SimonvanderMarel/ConfigFileESP32/Hardware design/PCBA/Design files/BOM_Home_Automation_Device_PCB1_2026-02-15.xlsx

No. | Quantity | Comment | Designator | Footprint | Value | Manufacturer Part | Manufacturer | Supplier Part | Supplier
1 | 1 | HX PH254-01-03-Z-L11.5 pcb pin header | AMS312 | HDR-TH_3P-P2.54-V-M-1 |  | HX PH254-01-03-Z-L11.5 pcb pin header | hanxia(韩下) | C52016391 | LCSC
2 | 7 | 22uF | C1,C2,C3,C4,C5,C6,C7 | C1206 | 22uF | CL31A226KAHNNNE | SAMSUNG(三星) | C12891 | LCSC
3 | 3 | 470531000 | CN1,CN2,CN3 | CONN-TH_4P-P2.54_0470531000 |  | 470531000 | MOLEX | C3025061 | LCSC
4 | 2 | SS34 | D1,D2 | SMA_L4.3-W2.6-LS5.2-RD |  | SS34 | MDD(辰达半导体) | C8678 | LCSC
5 | 1 | DC005 | DC1 | DC-IN-TH_DC005 |  | DC005 | SHOU HAN(首韩) | C431533 | LCSC
6 | 4 | DB125-2.54-3P-GN-S | DIO1,DIO2,DIO3,DIO4 | CONN-TH_DB125-2.54-3P-GN |  | DB125-2.54-3P-GN-S | DORABO(地博电气) | C918121 | LCSC
7 | 1 | FH1-200CK-B | FH1 | FUSE-TH_L24.8-W9.8-P22.60 |  | FH1-200CK-B | HONGJU(宏聚) | C268205 | LCSC
8 | 2 | BLM18PG121SN1D | L1,L2 | L0603 |  | BLM18PG121SN1D | muRata(村田) | C14709 | LCSC
9 | 3 | DB301V-3.5-2P-GN-S | P1,P2,VIN | CONN-TH_DB301V-3.5-2P-GN |  | DB301V-3.5-2P-GN-S | DORABO(地博电气) | C695629 | LCSC
10 | 2 | AO3400A | Q3,Q4 | SOT-23-3_L2.9-W1.3-P1.90-LS2.4-BR |  | AO3400A | AOS | C20917 | LCSC
11 | 4 | 330Ω | R5,R6,R11,R16 | R0603 | 330Ω | 0603WAF3300T5E | UNI-ROYAL(厚声) | C23138 | LCSC
12 | 4 | 10kΩ | R7,R8,R15,R17 | R0603 | 10kΩ | 0603WAF1002T5E | UNI-ROYAL(厚声) | C25804 | LCSC
13 | 4 | 4.7kΩ | R9,R10,R19,R20 | R0603 | 4.7kΩ | 0603WAF4701T5E | UNI-ROYAL(厚声) | C23162 | LCSC
14 | 1 | 82kΩ | R18 | R0603 | 82kΩ | 0603WAF8202T5E | UNI-ROYAL(厚声) | C23254 | LCSC
15 | 1 | ESP32-DEVKITC-VE | U1 | BULETM-SMD_ESP32-DEVKITC |  | ESP32-DEVKITC-VE | ESPRESSIF(乐鑫) | C20437001 | LCSC
16 | 1 | AMS1117-5.0 | U2 | SOT-223_L6.5-W3.5-P2.30-LS7.0-BR |  | AMS1117-5.0 | AMS | C6187 | LCSC
