SimonvanderMarel/ConfigFileESP32/Hardware design/Printed cover/Printed_Back_v2_higher.step

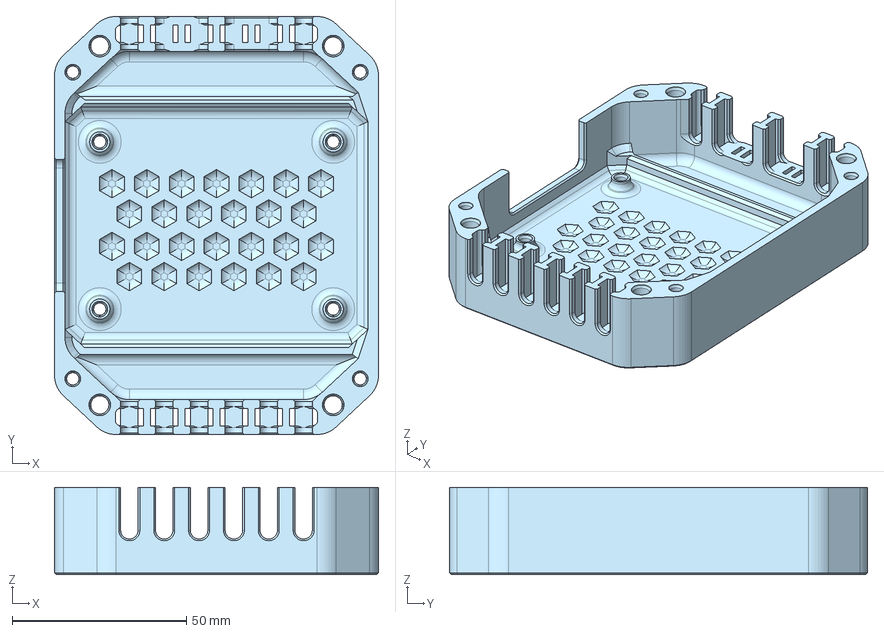
[picture p1: CAD file, 2026-04-04]
Hardware design/Printed cover/Printed_Back_v2_higher.step
93.0 x 120.0 x 25.0 mm
