SimonvanderMarel/ConfigFileESP32/Hardware design/RadiatorOptimizer/Radiator_Mount_Bracket_Type_1.step

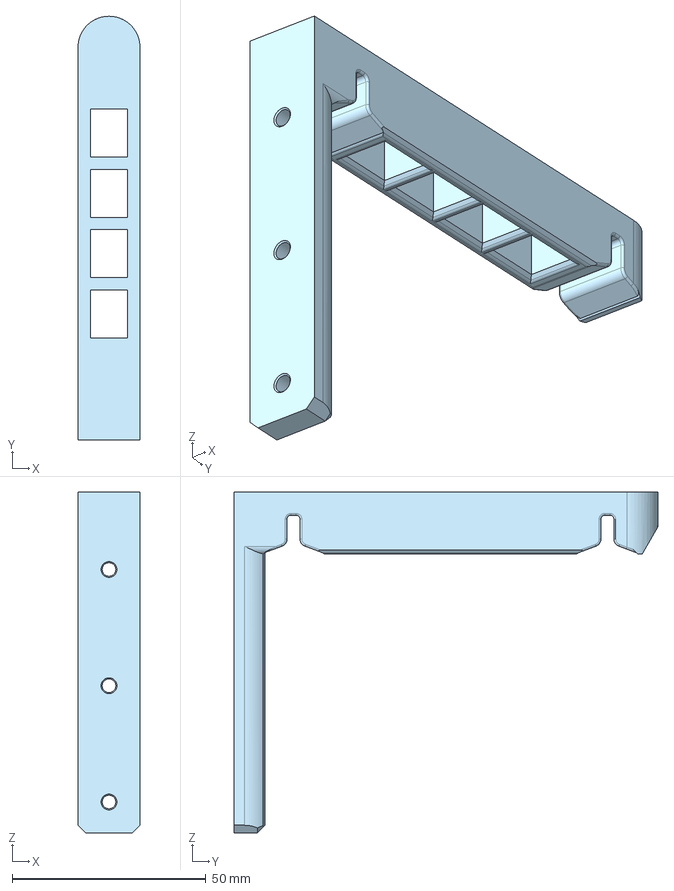
[picture p2: CAD file, 2026-04-05]
Hardware design/RadiatorOptimizer/Radiator_Mount_Bracket_Type_1.step
16.0 x 109.3 x 88.0 mm
