SimonvanderMarel/ConfigFileESP32/Hardware design/Printed cover/Printed_Cap_5mm.step

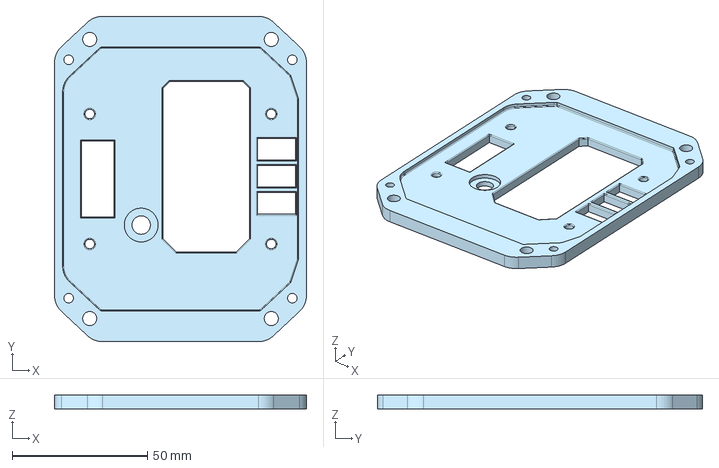
[picture p3: CAD file, 2026-04-04]
Hardware design/Printed cover/Printed_Cap_5mm.step
93.0 x 120.0 x 5.20 mm
