SimonvanderMarel/ConfigFileESP32/Hardware design/RadiatorOptimizer/Radiator_Cap_light_Sensor.step

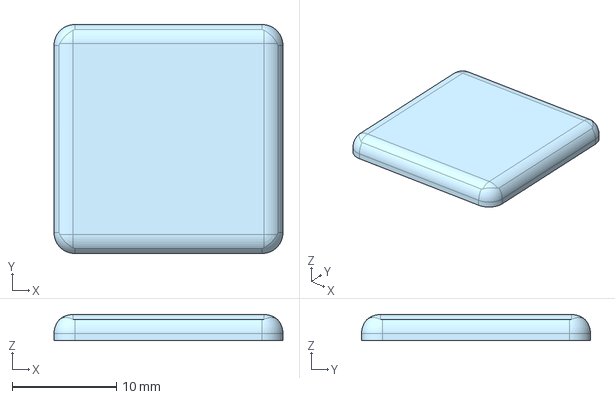
[picture p4: CAD file, 2026-04-04]
Hardware design/RadiatorOptimizer/Radiator_Cap_light_Sensor.step
22.0 x 22.0 x 2.50 mm
