SimonvanderMarel/ConfigFileESP32/Hardware design/Printed cover/Printed_Cap.step

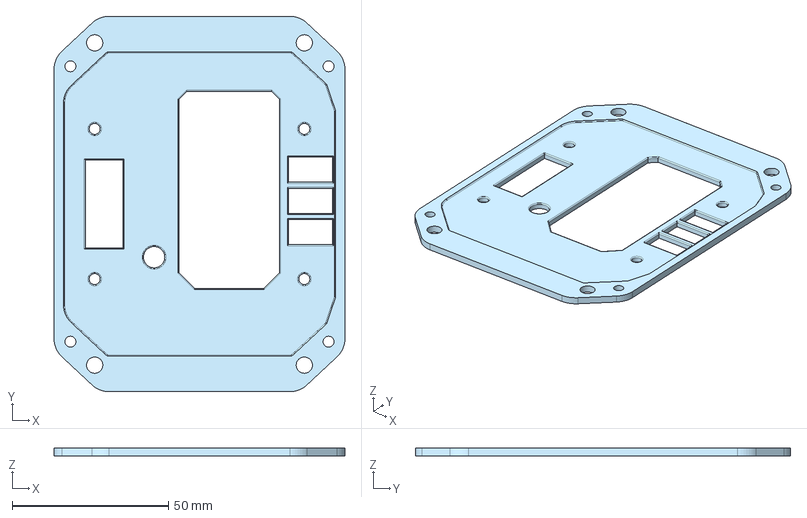
[picture p5: CAD file, 2026-03-26]
Hardware design/Printed cover/Printed_Cap.step
93.0 x 120.0 x 2.40 mm
