SimonvanderMarel/ConfigFileESP32/Hardware design/RadiatorOptimizer/Radiator_Cap_Lower.step

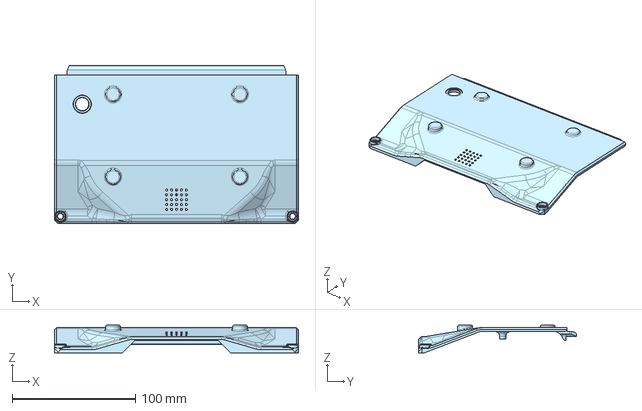
[picture p6: CAD file, 2026-04-04]
Hardware design/RadiatorOptimizer/Radiator_Cap_Lower.step
198.0 x 128.6 x 22.4 mm
