SimonvanderMarel/ConfigFileESP32/Hardware design/Printed cover/Printed_Back.step

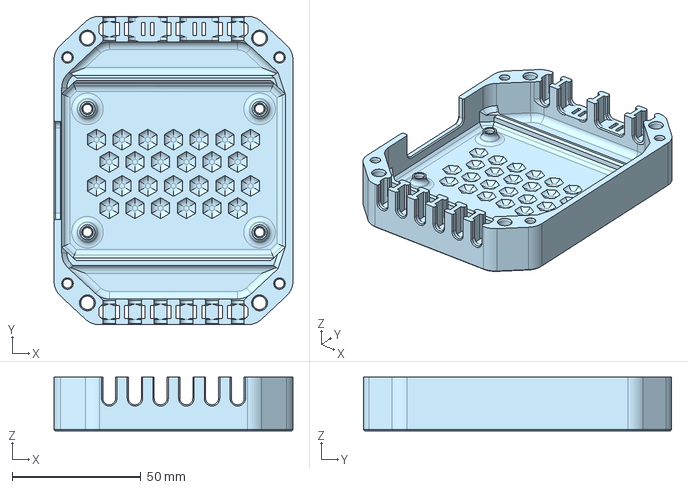
[picture p7: CAD file, 2026-03-26]
Hardware design/Printed cover/Printed_Back.step
93.0 x 120.0 x 21.0 mm
