SimonvanderMarel/ConfigFileESP32/Hardware design/RadiatorOptimizer/Radiator_PCB_Holder.step

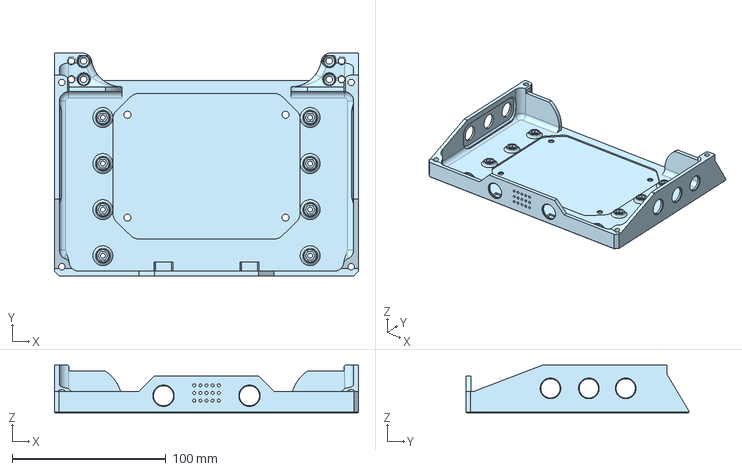
[picture p8: CAD file, 2026-04-04]
Hardware design/RadiatorOptimizer/Radiator_PCB_Holder.step
198.0 x 145.2 x 31.2 mm
