SimonvanderMarel/ConfigFileESP32/Hardware design/RadiatorOptimizer/Radiator_FanHolders.step

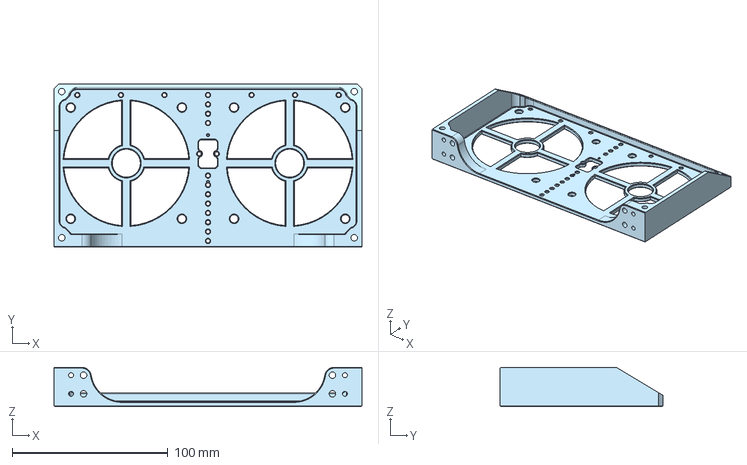
[picture p9: CAD file, 2026-04-04]
Hardware design/RadiatorOptimizer/Radiator_FanHolders.step
198.0 x 105.0 x 25.2 mm
