SimonvanderMarel/ConfigFileESP32/Hardware design/RadiatorOptimizer/Radiator_Cap_Higher.step

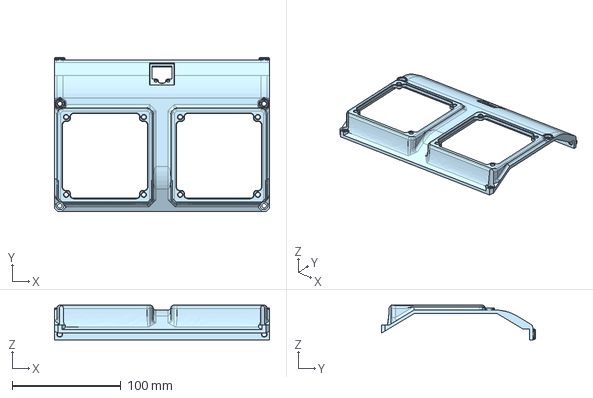
[picture p10: CAD file, 2026-04-04]
Hardware design/RadiatorOptimizer/Radiator_Cap_Higher.step
198.0 x 141.4 x 32.2 mm
