SimonvanderMarel/ConfigFileESP32/(list of files, cad)

Other CAD files:
Hardware design/Printed cover/Printed_Back.stl
Hardware design/Printed cover/Printed_Cap.stl
