SimonvanderMarel/ConfigFileESP32/Hardware design/PCBA/SCH_Home_Automation_Device_2026-02-15.pdf

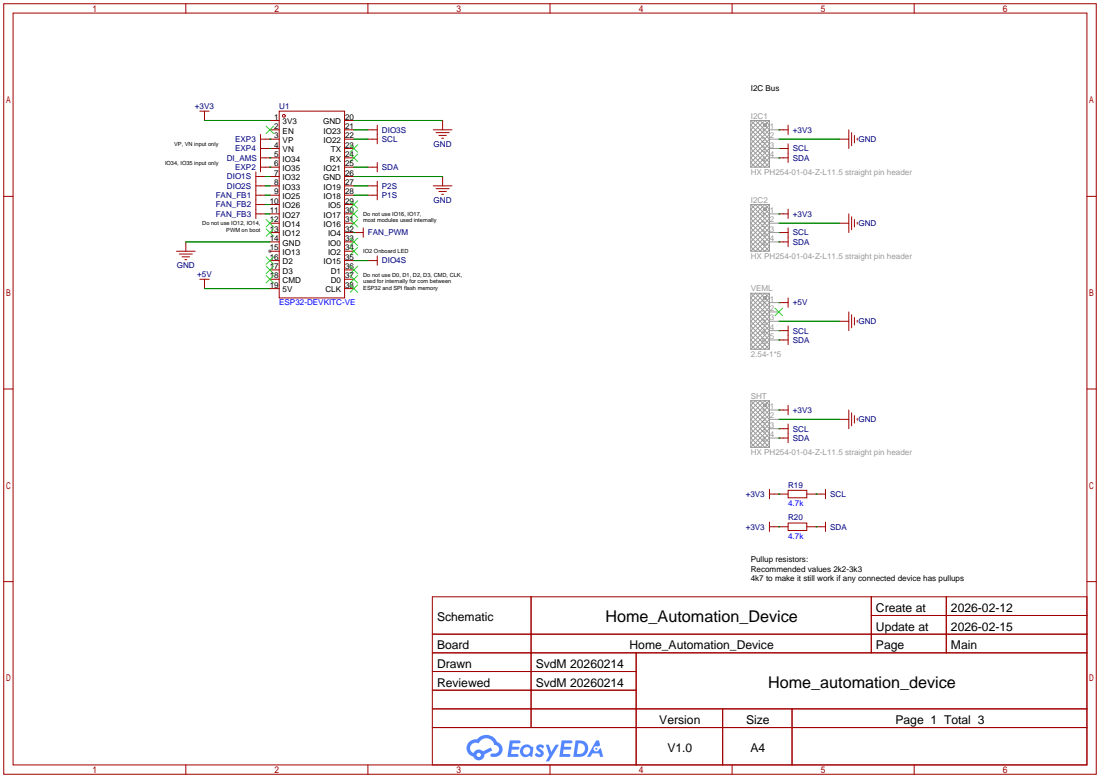
[picture p11: page 1]

VP, VN input only

Do not use IO16, IO17,
most modules used internally
FAN_PWM

Do not use D0, D1, D2, D3, CMD, CLK,
used for internally for com between
ESP32 and SPI flash memory

Pullup resistors:
Recommended values 2k2-3k3
4k7 to make it still work if any connected device has pullups

Schematic | Home_Automation_Device | Create at | 2026-02-12

Update at | 2026-02-15

Board | Home_Automation_Device | Page | Main
Drawn | SvdM 20260214 | Home_automation_device
Reviewed | SvdM 20260214

Version | Size | Page 1 Total 3
V1.0 | A4

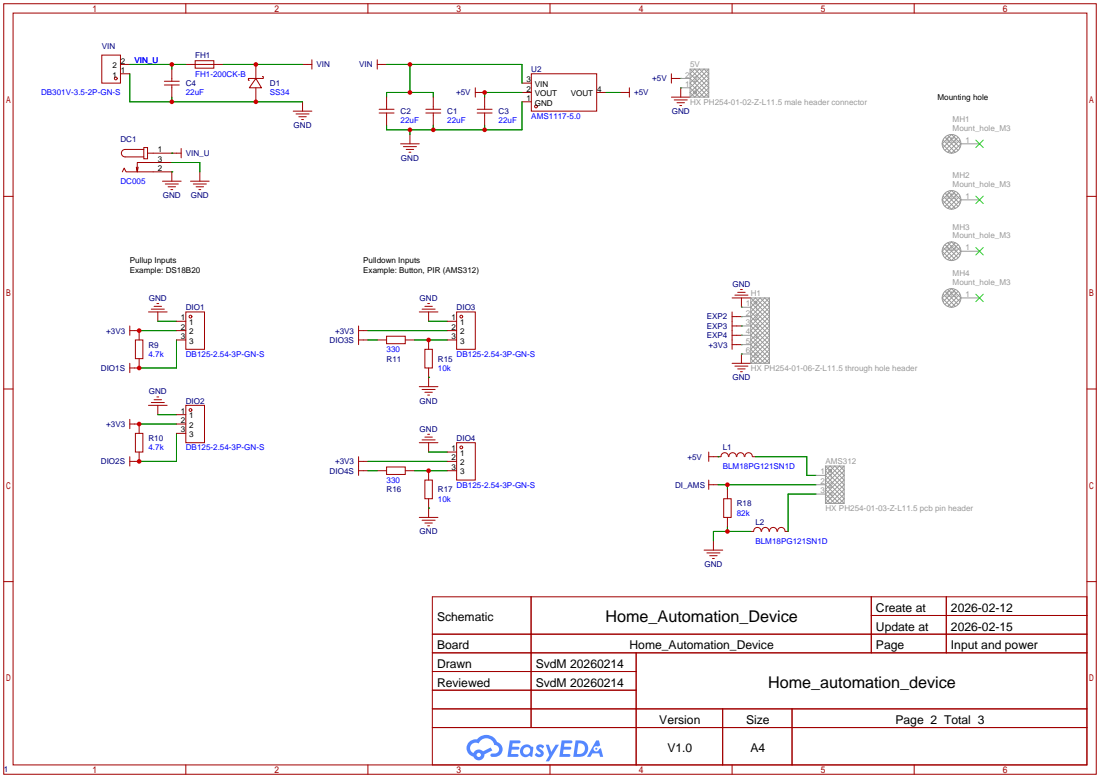
[picture p12: page 2]

Schematic | Home_Automation_Device | Create at | 2026-02-12

Update at | 2026-02-15

Board | Home_Automation_Device | Page | Input and power
Drawn | SvdM 20260214 | Home_automation_device
Reviewed | SvdM 20260214

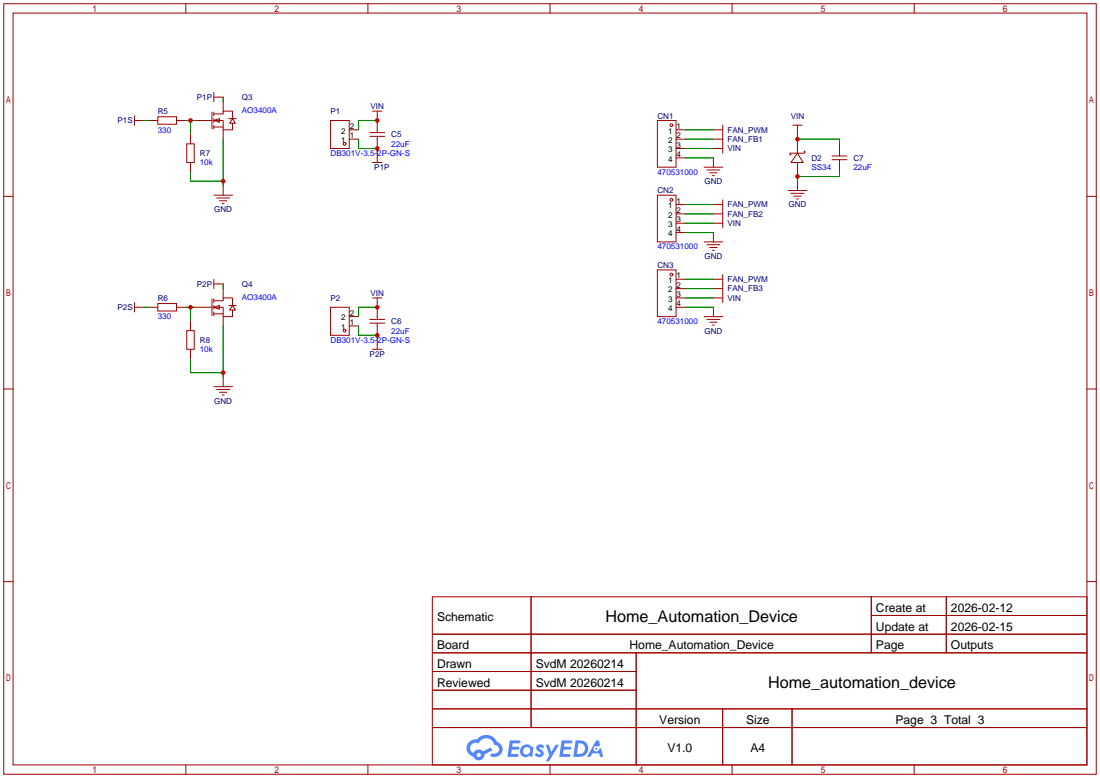
[picture p13: page 3]

Schematic | Home_Automation_Device | Create at | 2026-02-12

Update at | 2026-02-15

Board | Home_Automation_Device | Page | Outputs
Drawn | SvdM 20260214 | Home_automation_device
Reviewed | SvdM 20260214
