SimonvanderMarel/ConfigFileESP32/(list of files, drawings)

Other design files:
Hardware design/PCBA/EasyEDA files/ProDoc_Home_Automation_Device_2026-02-15.epro
