SimonvanderMarel/ConfigFileESP32/(commit log)

2026-02-15 PCBA design
    [BOM_Home_Automation_Device_PCB1_2026-02-15.xlsx, PickAndPlace_PCB1_2026-02-15.xlsx, ProDoc_Home_Automation_Device_2026-02-15.epro]
2026-03-26 Cover and config update
    [Printed_Back.step, Printed_Back.stl, Printed_Cap.step, Printed_Cap.stl]
2026-04-04 Radiator design
    [Printed_Back_v2_higher.step, Printed_Cap_5mm.step, Radiator_Cap_Higher.step, Radiator_Cap_Lower.step, Radiator_FanHolders.step, Radiator_PCB_Holder.step]
